Grix/LASDAC/Laser presentasjon.odp

## Laser DAC

  Av Gitle Mikkelsen, Thomas Heggland, Bård Gustav Hole Eide og Asbjørn Vik

## Oppgaven

- Designe en DAC for å styre en laser projektor
- Den skal følge ISP-DB25 protokollen.
- Kommunikasjon foregår over USB.

## Slide 3

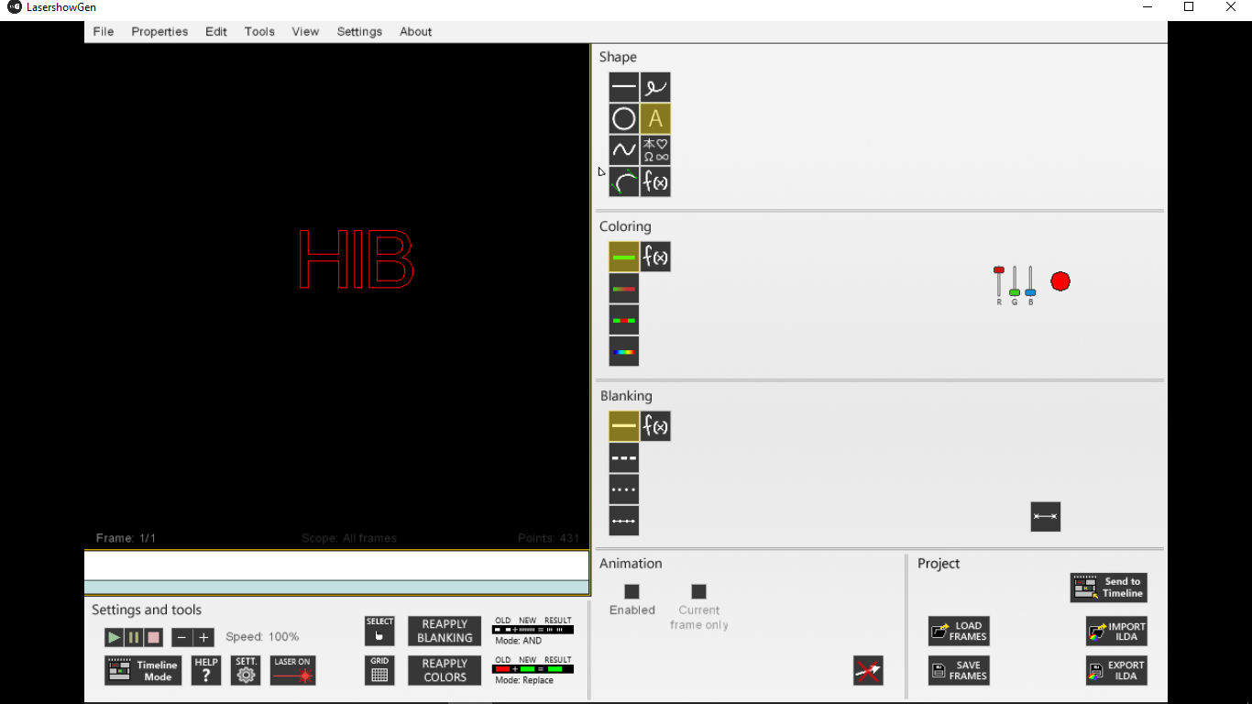
[picture p1: figure]

## Slide 4

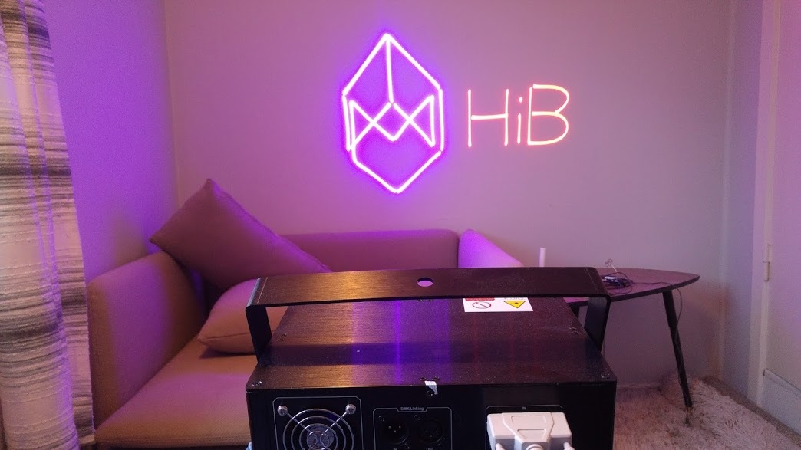
[picture p2: figure]

## Laserprojektorer

- Tegner ett bilde
- Hvert punkt har XY RGBI
- 30,000 punkter i sekundet
- Har begrensinger

## Analog del

- Designe forsterkere
- Velge dac løsning
- Strømforsyning
- Finne komponenter
- Designe kretskort

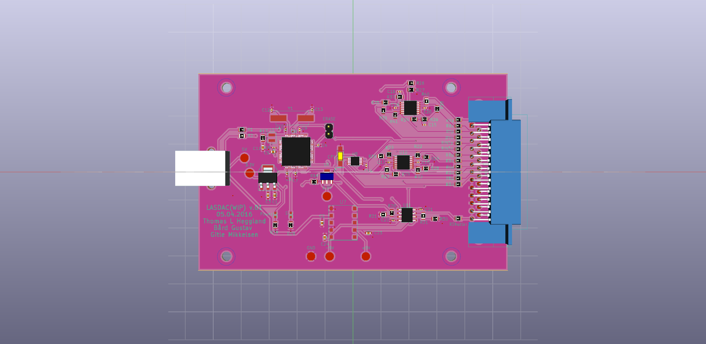
[picture p3: figure]

## Digital del

- Skrive firmware som kjører på mcu
- Skrive drivere

## Produksjon

- Får kortet produsert i Kina
- Feilsøking
- Levere

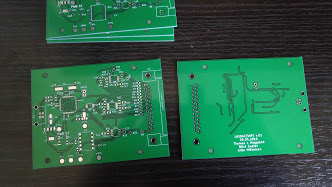
[picture p4: figure]
