Grix/LASDAC/documentation/lasdac_firmware_timechart_v0.1.pdf

### Lasdac firmware timechart v0.1

### Shutter output

### playing

### newFrameReady

### Frame Buffer 1 ( frame1[ ] )

### Frame Buffer 2 ( frame2[ ] )

DAC outputs | Blanked and centered | Blanked and centered

### frameAddress

newFrameAddress | frame2 | frame1 | frame2 | frame1

### framePos

### newFramePos

### USB isochronous data packet event

USB control packet event | | | | | | | STOP Shutter
H S | | ON | | Shutter OFF
Notes | | Several incoming USB isochronous packets contain data for the first laser frame | When transfer is finished, playing is enabled and the frame is gradually output to the DACs. Meanwhile, a second frame is being received over USB, filling the second frame buffer. | USB Control packets can issue various commands like setting shutter signal level. | The packets for the third frame (in blue) are received too late and the purple frame loops while the transfer finishes. | The packets for the fourth frame (in red) are received too early and are discarded because no buffers are available to store the data. | A STOP control packet stops and resets the output until a new frame is received.
frame1 | frame2 | frame1 | frame2

Time axis
