Grix/LASDAC/documentation/lasdac_firmware_flowchart_v0.4.pdf

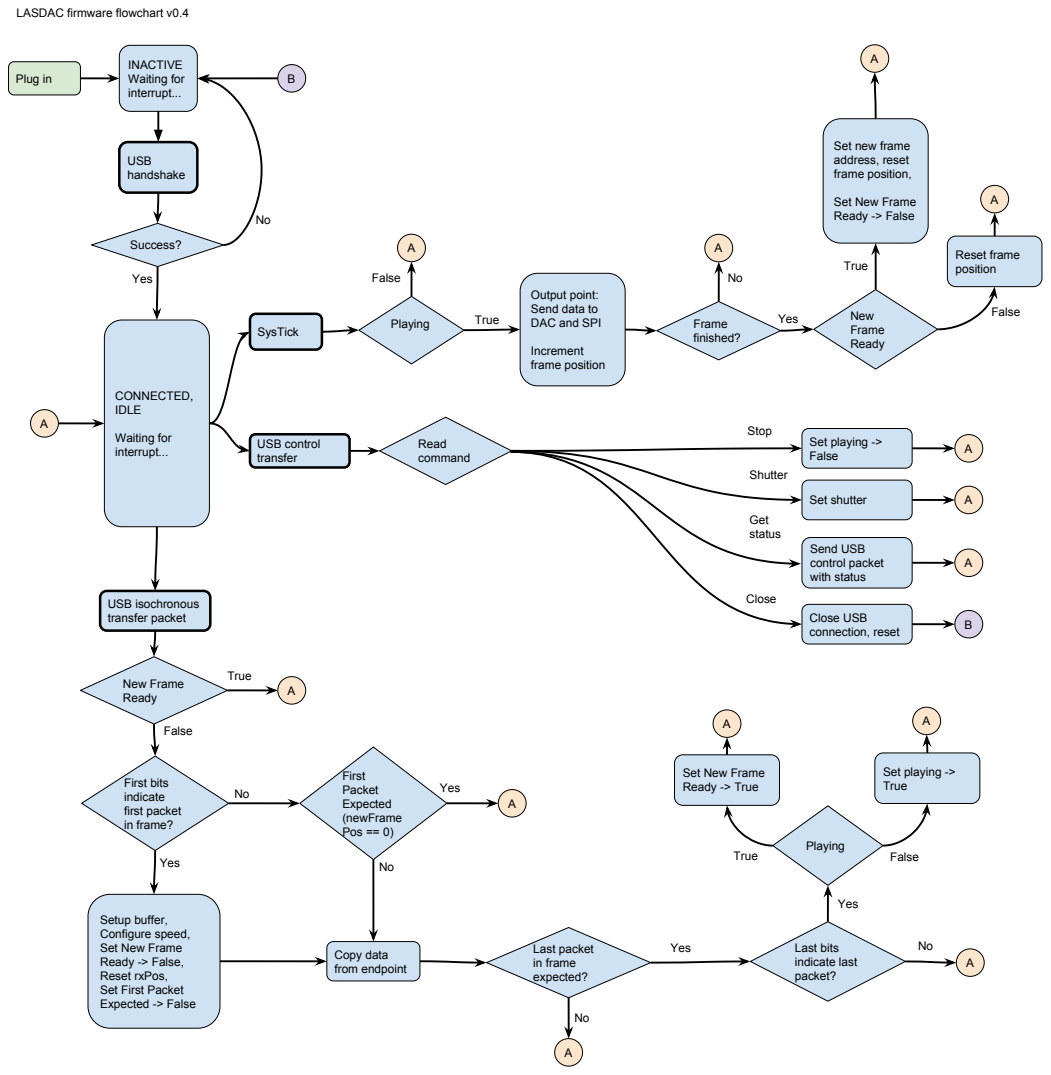
[picture p5: page 1]
INACTIVE Waiting for interrupt...; Success?; CONNECTED, IDLE; Waiting for interrupt...; USB handshake; Plug in; SysTick; Playing; Increment frame position; True; Frame; finished?; Yes; False; Reset frame position; USB control transfer; Read command; Set playing -> False; Stop; Set shutter; Shutter; Send USB control packet with status; Get status; Close USB connection, reset; Close; USB isochronous transfer packet; Copy data from endpoint; Last packet in frame expected?; New Frame Ready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

LASDAC firmware flowchart v0.4

Set new frame
address, reset
frame position,

Set New Frame
Ready -> False

Output point:
Send data to
DAC and SPI

Ready -> True

Setup buffer,
Configure speed,
Ready -> False,
Reset rxPos,
Set First Packet
Expected -> False
