Grix/LASDAC/ltspice/lasdac.asc

C1: cap; 0.05u
C2: cap; 0.05u
C3: cap; 390p
C4: cap; 390p
L1: ind; 500u; Rser=100
L2: ind; 500u; Rser=100
R1: res; 10k; tol=1
R2: res; 10k; tol=1
R3: res; 10k; tol=1
R4: res; 10k; tol=1
R5: res; 10k; tol=1
R6: res; 10k; tol=1
R7: res; 10k; tol=1
R8: res; 10k; tol=1
R9: res; 10k; tol=1
R10: res; 10k; tol=1
R11: res; 150; tol=1
R12: res; 1meg; tol=1
R13: res; 10k; tol=1
R14: res; 10k; tol=1
R15: res; 1.65k; tol=1
R16: res; 10k; tol=1
R17: res; 10k; tol=1
R18: res; 10k; tol=1
R19: res; 1.65k; tol=1
R20: res; 10k; tol=1
R21: res; 1.65k; tol=1
R22: res; 10k; tol=1
R23: res; 10k; tol=1
R24: res; 5.11k; tol=1
U1: tl084
U2: tl084
U3: tl084
U4: tl084
U5: tl084
U6: tl084
U7: tl084
U8: tl084
U9: tl084
U10: tl084
V1: voltage; 2.5; Rser=0.5
V2: voltage; PWL(0 0 0.997m 0 1m 2.5); Rser=7.5
V3: voltage; 9; Rser=10 Cpar=4.7u
V4: voltage; -9; Rser=10 Cpar=4.7u
V5: voltage; PWL(0 0.4167 0.997m 0.4167 1m 2.0833); Rser=3
V6: voltage; PWL(0 0 0.997m 0 1m 3.3); Rser=3
Named nets: 0, V2.5D, VN9D, V9D, VoRpos, VoGpos, VoBpos, VoIpos, ViB, ViG, ViR, ViI, VoBneg, VoGneg, VoRneg, VoIneg, V1.25D, VoXpos, ViY, ViX, VoXneg, VoYpos, VoYneg, VoS, ViS
.tran 0 2m 0m uic
Simple cable simulation
Voltage references
Color channels
X / Y channels
Shutter
