Grix/LASDAC/ltspice/powersupplies.asc

C1: cap; 321.4pF
C2: cap; 4.7uF
C3: cap; 100uF
C4: cap; 4.7uF
C5: cap; 257.9pF
C6: cap; 100uF
D1: schottky
D2: schottky
L1: ind; 216.5uH
L2: ind; 173.1uH
R1: res; 10k
R2: res; 62k
R3: res; 180
R4: res; 39.6m
R5: res; 1k
R6: res; 62k
R7: res; 10k
R8: res; 63m
R9: res; 1k
U1: MC34063
U2: MC34063
V1: voltage; 5V
V2: voltage; 5V
Named nets: 0
.tran 0.12 startup
