Grix/LASDAC/PCB/LASDAC.kicad_pcb

## KiCad design PCB/LASDAC.kicad_pcb (2016-04-17)

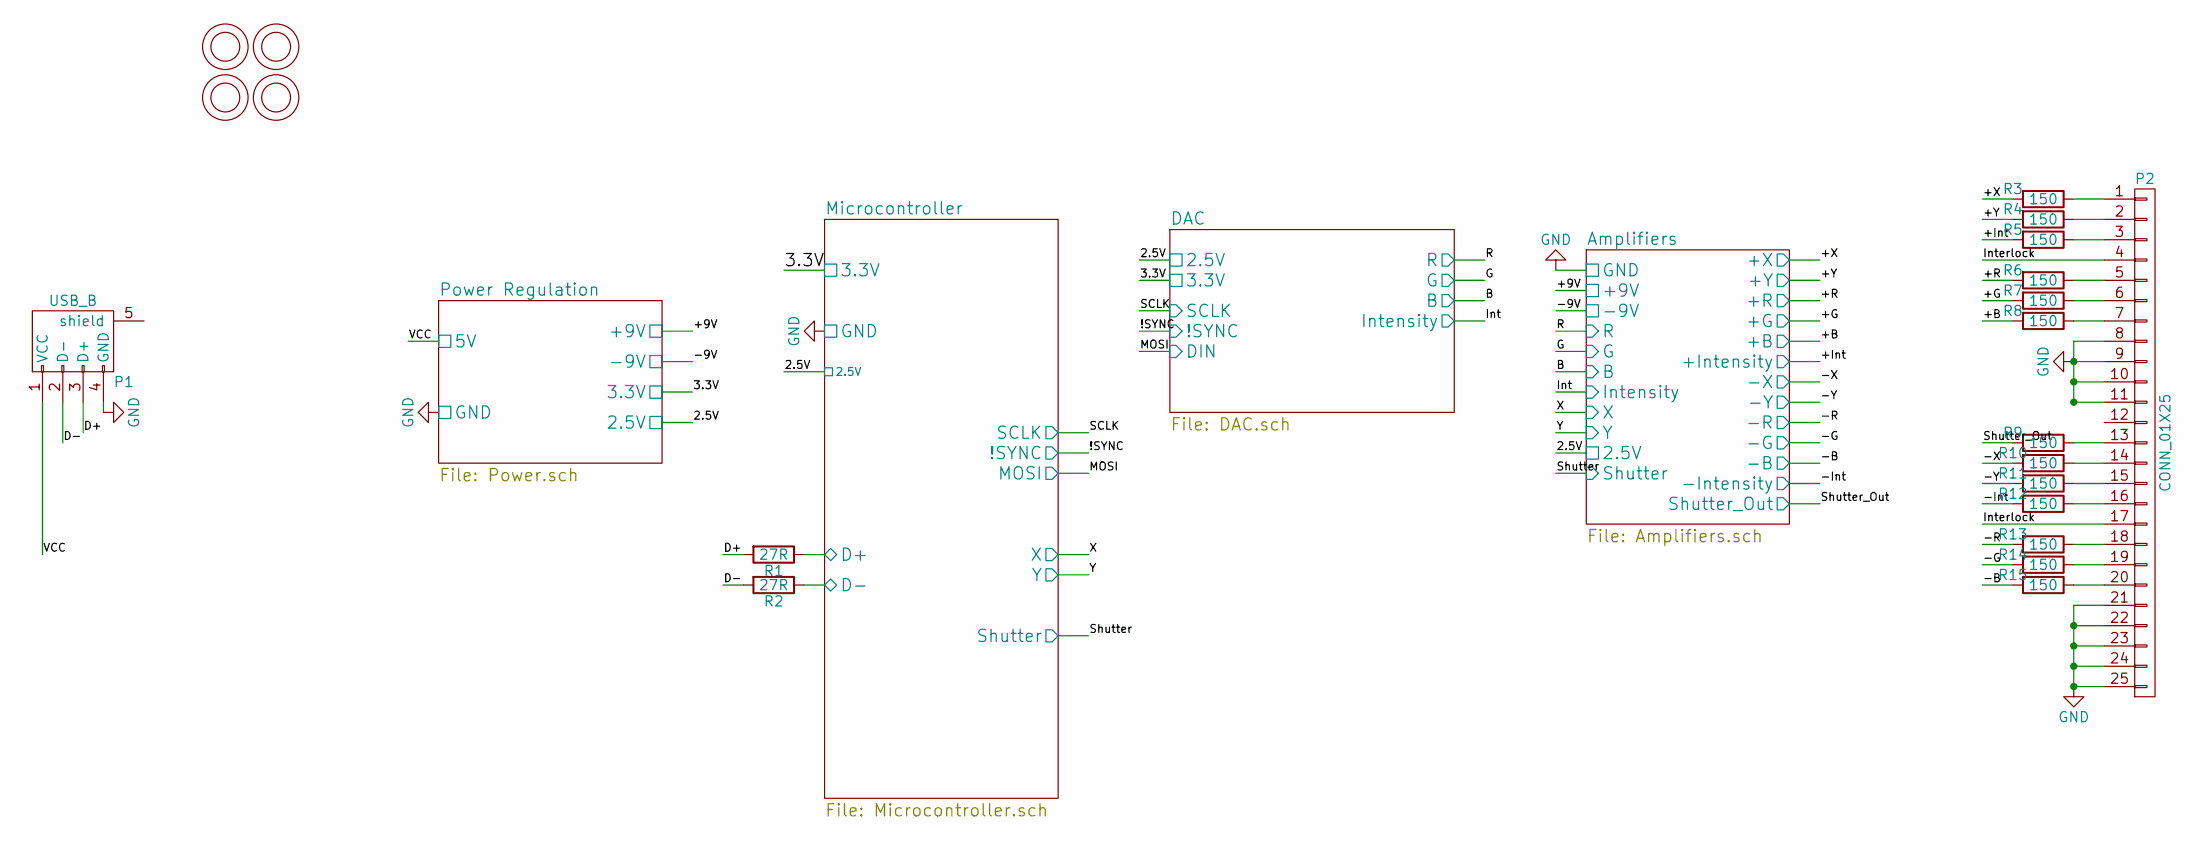
[picture p11: schematic LASDAC.sch, Main]

Parts:
H1, H2, H3, H4: Mounting_Hole; MountingHole_3.2mm_M3
P1: USB_B
P2: CONN_01X25; DB25FC
R1, R2: 27R; R_0805
R3, R4, R5, R6, R7, R8, R9, R10, R11, R12, R13, R14, R15: 150; R_0805

Connections:
/Amplifiers/+B: R8.2; also elsewhere on the board
/Amplifiers/+G: R7.2; also elsewhere on the board
/Amplifiers/+Intensity: R5.2; also elsewhere on the board
/Amplifiers/+R: R6.2; also elsewhere on the board
/Amplifiers/+X: R3.2; also elsewhere on the board
/Amplifiers/+Y: R4.2; also elsewhere on the board
/Amplifiers/-B: R15.2; also elsewhere on the board
/Amplifiers/-G: R14.2; also elsewhere on the board
/Amplifiers/-Intensity: R12.2; also elsewhere on the board
/Amplifiers/-R: R13.2; also elsewhere on the board
/Amplifiers/-X: R10.2; also elsewhere on the board
/Amplifiers/-Y: R11.2; also elsewhere on the board
/Amplifiers/Shutter_Out: R9.2; also elsewhere on the board
/D+: P1.3 (D+), R1.2
/D-: P1.2 (D-), R2.2
/Interlock: P2.4, P2.17
/Microcontroller/D+: R1.1; also elsewhere on the board
/Microcontroller/D-: R2.1; also elsewhere on the board
/Power Regulation/5V: P1.1 (VCC); also elsewhere on the board
GND: P1.4 (GND), P2.8, P2.9, P2.10, P2.11, P2.21, P2.22, P2.23, P2.24, P2.25; also elsewhere on the board
unnamed: P2.1, R3.1
unnamed: P2.2, R4.1
unnamed: P2.3, R5.1
unnamed: P2.5, R6.1
unnamed: P2.6, R7.1
unnamed: P2.7, R8.1
unnamed: P2.13, R9.1
unnamed: P2.14, R10.1
unnamed: P2.15, R11.1
unnamed: P2.16, R12.1
unnamed: P2.18, R13.1
unnamed: P2.19, R14.1
unnamed: P2.20, R15.1

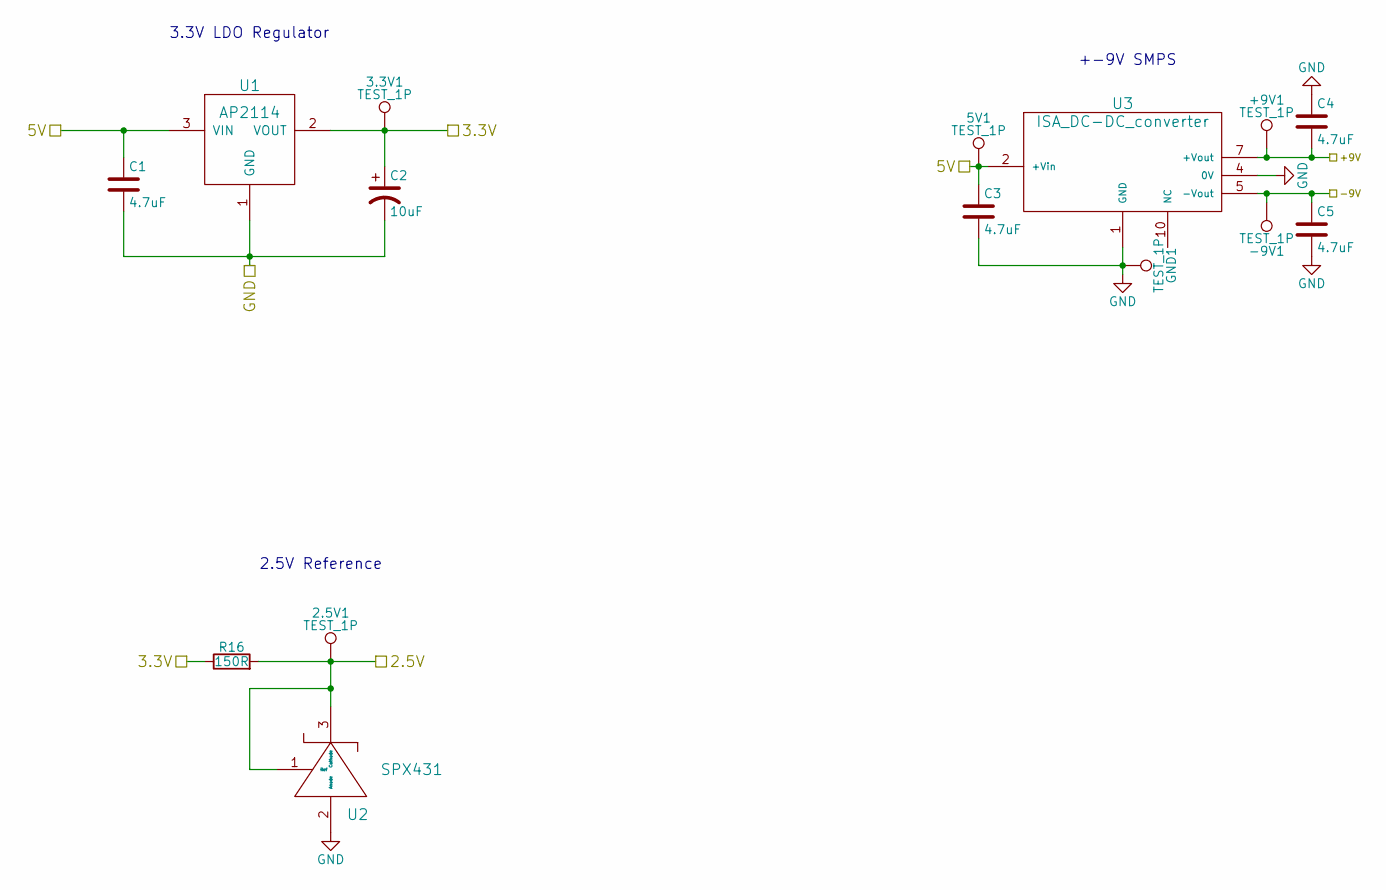
[picture p12: schematic Power.sch, Power Supplies]

Parts:
2.5V1, 3.3V1, 5V1: TEST_1P; Measurement_Point_Round-SMD-Pad_Big
+9V1: TEST_1P; Measurement_Point_Round-SMD-Pad_Big
-9V1: TEST_1P; Measurement_Point_Round-SMD-Pad_Big
C1, C4, C5: 4.7uF; C_0603
C2: 10uF
C3: 4.7uF; c_elec_4x5.8
GND1: TEST_1P; Measurement_Point_Round-SMD-Pad_Big
R16: 150R; R_0805
U1: AP2114; SOT-223
U2: SPX431; SOT89-3_Housing
U3: ISA_DC-DC_converter; SOIC-10

Connections:
/Amplifiers/2.5V: 2.5V1.1, R16.2, U2.1 (Ref), U2.3 (Cathode); also elsewhere on the board
/Amplifiers/+9V: +9V1.1, C4.2, U3.7 (+Vout); also elsewhere on the board
/Amplifiers/-9V: -9V1.1, C5.1, U3.5 (-Vout); also elsewhere on the board
/DAC/3.3V: 3.3V1.1, C2.1, R16.1, U1.2 (VOUT); also elsewhere on the board
/Power Regulation/5V: 5V1.1, C1.1, C3.1, U1.3 (VIN), U3.2 (+Vin); also elsewhere on the board
GND: C1.2, C2.2, C3.2, C4.1, C5.2, GND1.1, U1.1 (GND), U2.2 (Anode), U3.1 (GND), U3.4 (0V); also elsewhere on the board

Notes on the sheet:
3.3V LDO Regulator
+-9V SMPS
2.5V Reference

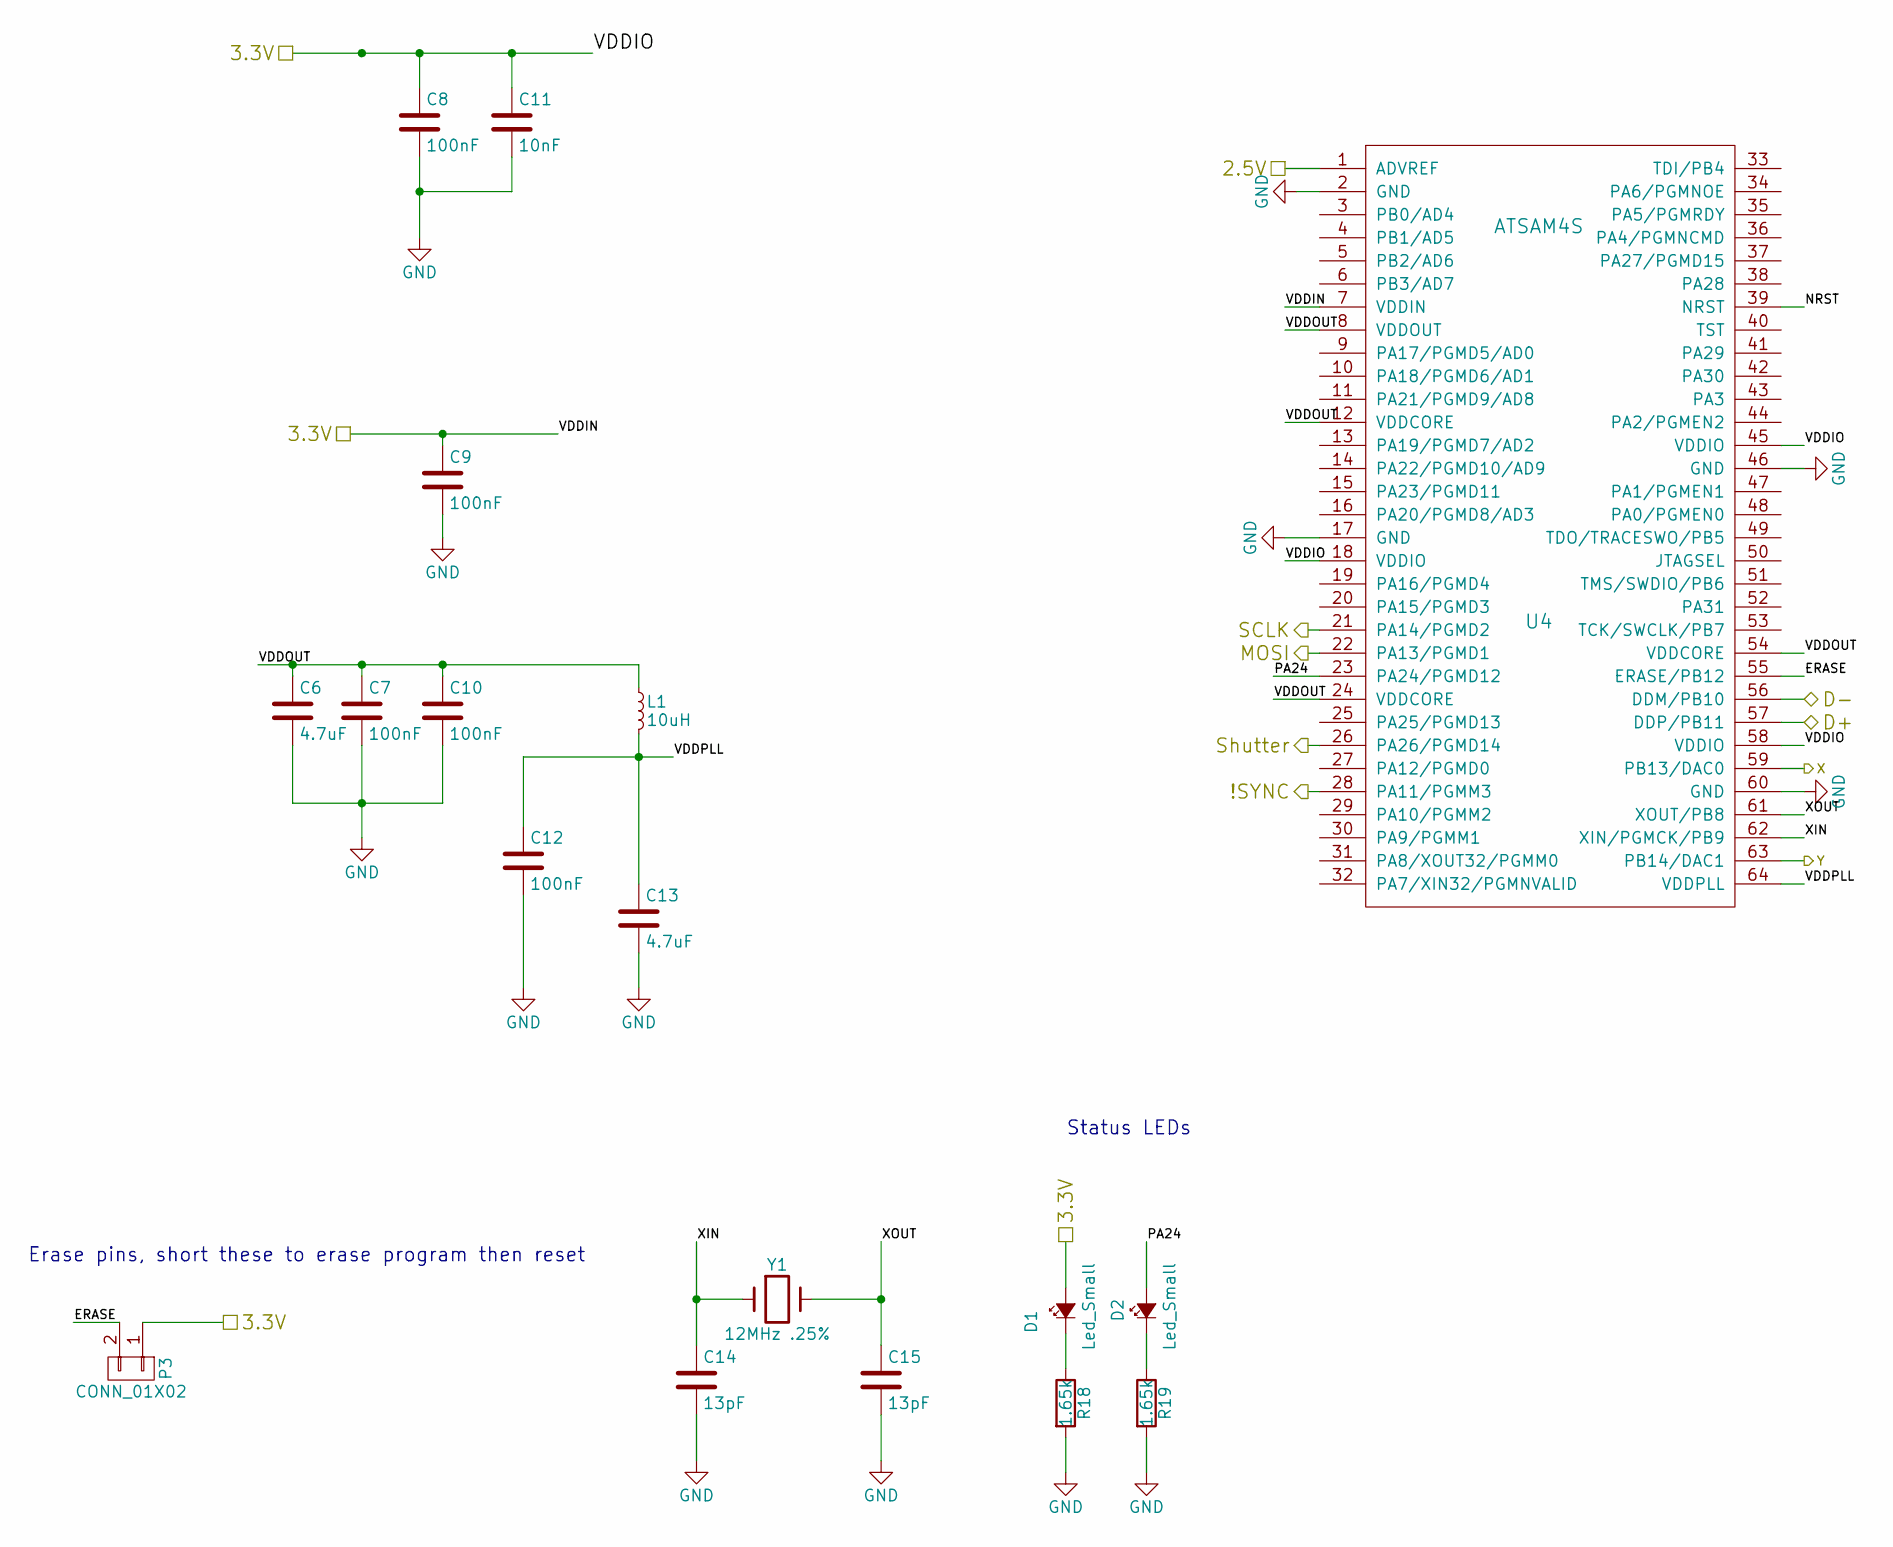
[picture p13: schematic Microcontroller.sch, Microcontroller]

Parts:
C6, C13: 4.7uF; C_0603
C7, C8, C9, C10, C12: 100nF; C_0402
C11: 10nF; C_0402
C14, C15: 13pF; C_0402
D1, D2: Led_Small; LED_0603
L1: 10uH; Inductor_SM_1008i2520m
P3: CONN_01X02
R18, R19: 1.65k; R_0805
U4: ATSAM4S; LQFP-64_10x10mm_Pitch0.5mm
Y1: 12MHz .25%; Crystal_HC49-SD_SMD

Connections:
/Amplifiers/2.5V: U4.1 (ADVREF); also elsewhere on the board
/Amplifiers/Shutter: U4.26 (PA26/PGMD14); also elsewhere on the board
/Amplifiers/X: U4.59 (PB13/DAC0); also elsewhere on the board
/Amplifiers/Y: U4.63 (PB14/DAC1); also elsewhere on the board
/DAC/3.3V: C8.1, C9.1, C11.1, D1.2 (A), P3.1, U4.7 (VDDIN), U4.18 (VDDIO), U4.45 (VDDIO), U4.58 (VDDIO); also elsewhere on the board
/DAC/!SYNC: U4.28 (PA11/PGMM3); also elsewhere on the board
/DAC/Din: U4.22 (PA13/PGMD1); also elsewhere on the board
/DAC/SCLK: U4.21 (PA14/PGMD2); also elsewhere on the board
/Microcontroller/D+: U4.57 (DDP/PB11); also elsewhere on the board
/Microcontroller/D-: U4.56 (DDM/PB10); also elsewhere on the board
/Microcontroller/ERASE: P3.2, U4.55 (ERASE/PB12); also elsewhere on the board
/Microcontroller/NRST: U4.39 (NRST)
/Microcontroller/PA24: D2.2 (A), U4.23 (PA24/PGMD12)
/Microcontroller/VDDOUT: C6.1, C7.1, C10.1, L1.1, U4.8 (VDDOUT), U4.12 (VDDCORE), U4.24 (VDDCORE), U4.54 (VDDCORE)
/Microcontroller/VDDPLL: C12.1, C13.1, L1.2, U4.64 (VDDPLL)
/Microcontroller/XIN: C14.1, U4.62 (XIN/PGMCK/PB9), Y1.1
/Microcontroller/XOUT: C15.1, U4.61 (XOUT/PB8), Y1.2
GND: C6.2, C7.2, C8.2, C9.2, C10.2, C11.2, C12.2, C13.2, C14.2, C15.2, R18.2, R19.2, U4.2 (GND), U4.17 (GND), U4.46 (GND), U4.60 (GND); also elsewhere on the board
unnamed: D1.1 (K), R18.1
unnamed: D2.1 (K), R19.1

Notes on the sheet:
Erase pins, short these to erase program then reset
Status LEDs

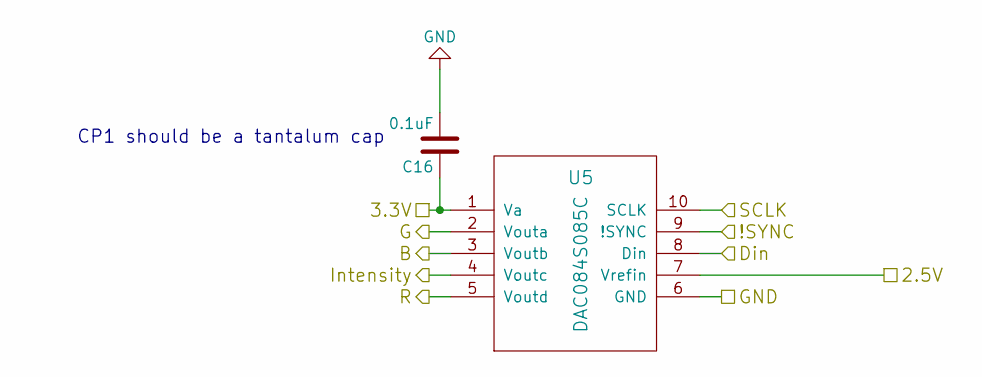
[picture p14: schematic DAC.sch, Digital to Analog Converter]

Parts:
C16: 0.1uF; C_0402
U5: DAC084S085C; MSOP-10_3x3mm_Pitch0.5mm

Connections:
/Amplifiers/2.5V: U5.7 (Vrefin); also elsewhere on the board
/Amplifiers/+B: U5.3 (Voutb); also elsewhere on the board
/Amplifiers/+G: U5.2 (Vouta); also elsewhere on the board
/Amplifiers/+Intensity: U5.4 (Voutc); also elsewhere on the board
/Amplifiers/+R: U5.5 (Voutd); also elsewhere on the board
/DAC/3.3V: C16.1, U5.1 (Va); also elsewhere on the board
/DAC/!SYNC: U5.9 (!SYNC); also elsewhere on the board
/DAC/Din: U5.8 (Din); also elsewhere on the board
/DAC/SCLK: U5.10 (SCLK); also elsewhere on the board
GND: C16.2, U5.6 (GND); also elsewhere on the board

Notes on the sheet:
CP1 should be a tantalum cap

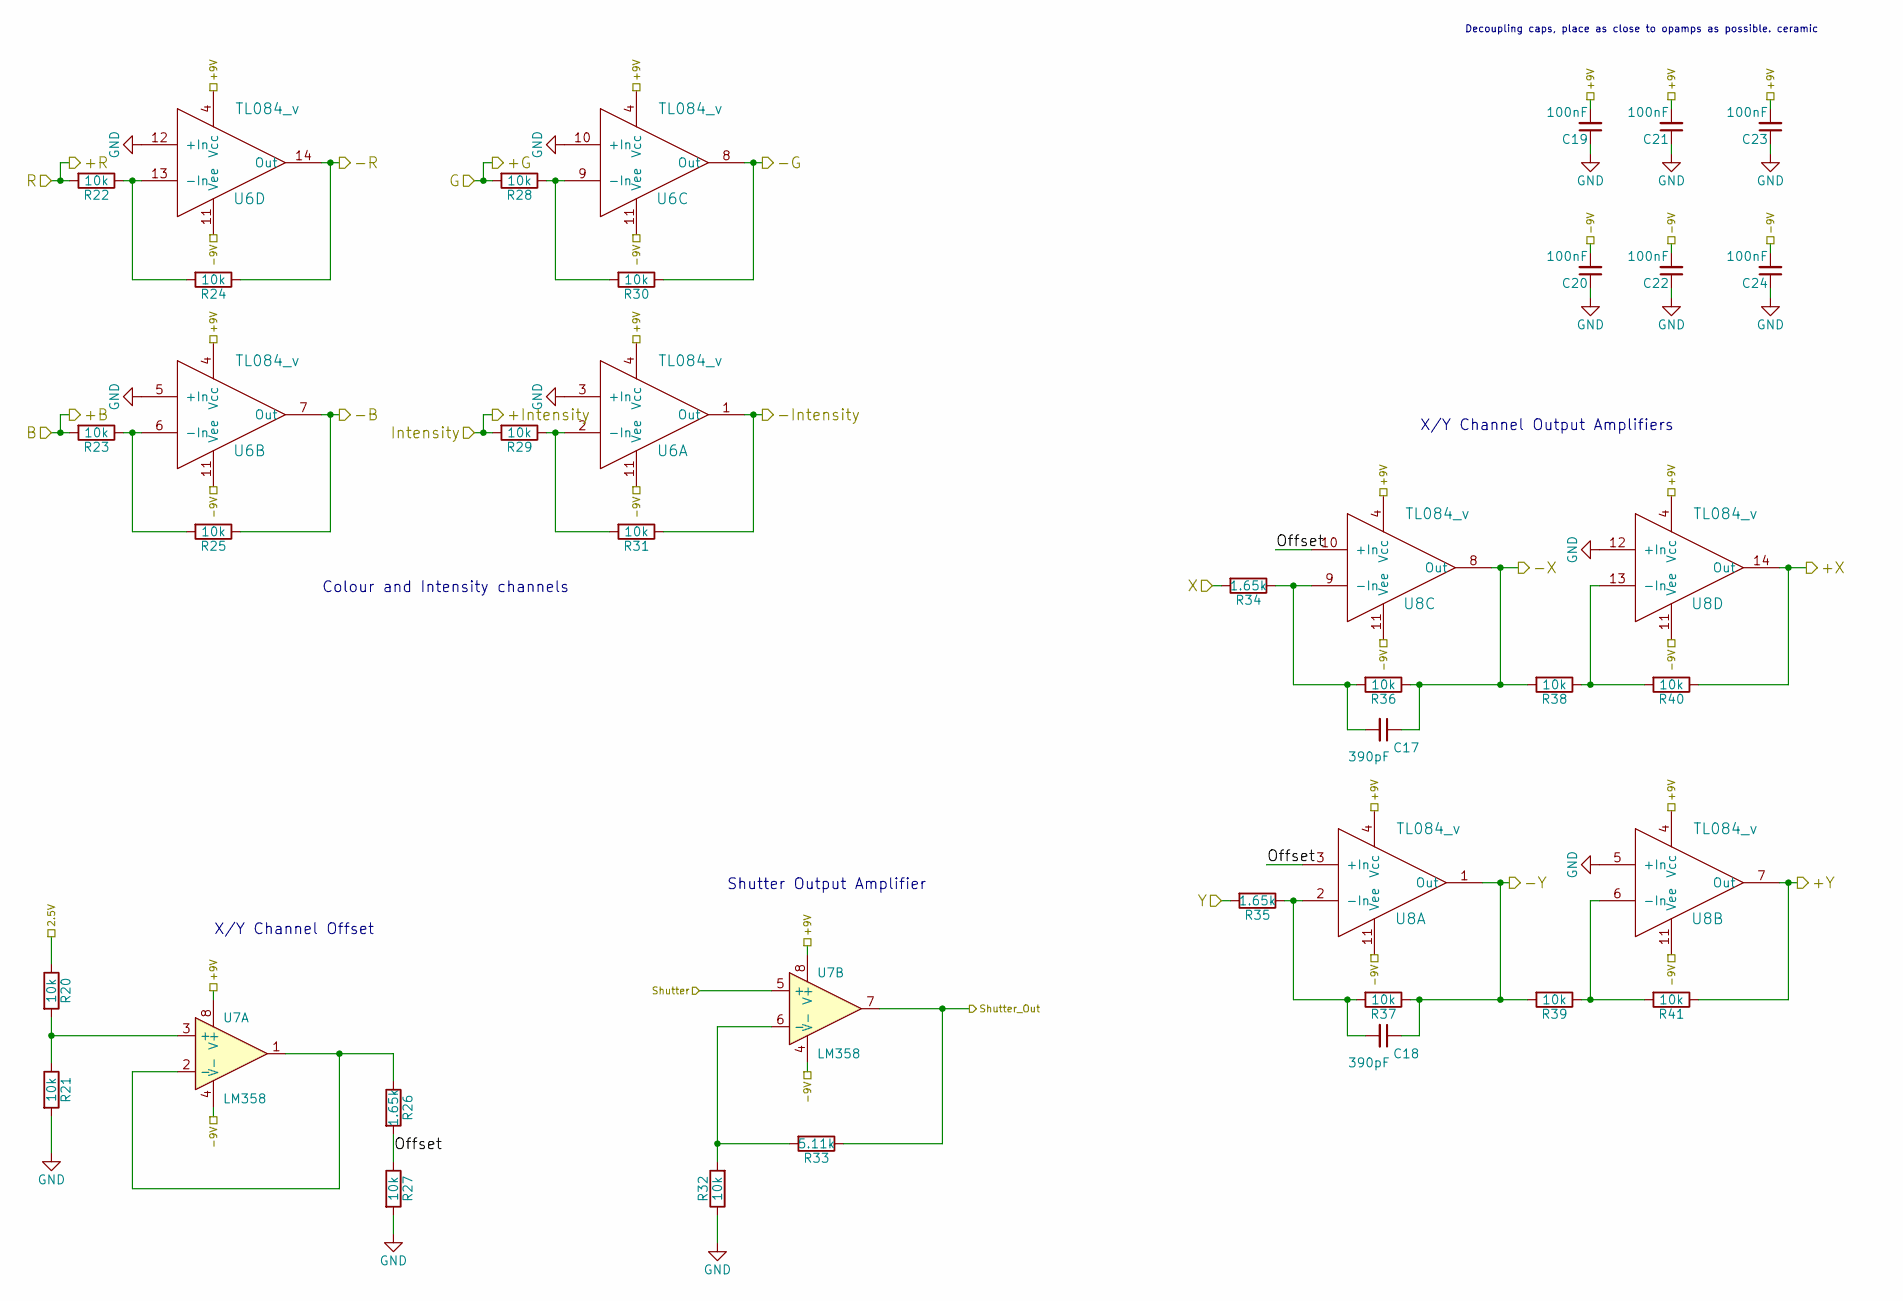
[picture p15: schematic Amplifiers.sch]

Parts:
C17, C18: 390pF; C_0402
C19, C20, C21, C22, C23, C24: 100nF; C_0402
R20, R21, R22, R23, R24, R25, R27, R28, R29, R30, R31, R32, R36, R37, R38, R39, R40, R41: 10k; R_0805
R26, R34, R35: 1.65k; R_0805
R33: 5.11k; R_0805
U6, U8: TL084_v; TSSOP-14_4.4x5mm_Pitch0.65mm
U7: LM358; SOIC-8_3.9x4.9mm_Pitch1.27mm

Connections:
/Amplifiers/2.5V: R20.1; also elsewhere on the board
/Amplifiers/+9V: C19.2, C21.2, C23.2, U6.4 (Vcc), U7.8 (V+), U8.4 (Vcc); also elsewhere on the board
/Amplifiers/+B: R23.2; also elsewhere on the board
/Amplifiers/+G: R28.2; also elsewhere on the board
/Amplifiers/+Intensity: R29.2; also elsewhere on the board
/Amplifiers/+R: R22.2; also elsewhere on the board
/Amplifiers/+X: R40.1, U8.14 (Out); also elsewhere on the board
/Amplifiers/+Y: R41.1, U8.7 (Out); also elsewhere on the board
/Amplifiers/-9V: C20.2, C22.2, C24.2, U6.11 (Vee), U7.4 (V-), U8.11 (Vee); also elsewhere on the board
/Amplifiers/-B: R25.1, U6.7 (Out); also elsewhere on the board
/Amplifiers/-G: R30.1, U6.8 (Out); also elsewhere on the board
/Amplifiers/-Intensity: R31.1, U6.1 (Out); also elsewhere on the board
/Amplifiers/-R: R24.1, U6.14 (Out); also elsewhere on the board
/Amplifiers/-X: C17.1, R36.1, R38.2, U8.8 (Out); also elsewhere on the board
/Amplifiers/-Y: C18.1, R37.1, R39.2, U8.1 (Out); also elsewhere on the board
/Amplifiers/Offset: R26.2, R27.1, U8.3 (+In), U8.10 (+In)
/Amplifiers/Shutter: U7.5 (+); also elsewhere on the board
/Amplifiers/Shutter_Out: R33.1, U7.7; also elsewhere on the board
/Amplifiers/X: R34.2; also elsewhere on the board
/Amplifiers/Y: R35.2; also elsewhere on the board
GND: C19.1, C20.1, C21.1, C22.1, C23.1, C24.1, R21.2, R27.2, R32.1, U6.3 (+In), U6.5 (+In), U6.10 (+In), U6.12 (+In), U8.5 (+In), U8.12 (+In); also elsewhere on the board
unnamed: C17.2, R34.1, R36.2, U8.9 (-In)
unnamed: C18.2, R35.1, R37.2, U8.2 (-In)
unnamed: R20.2, R21.1, U7.3 (+)
unnamed: R22.1, R24.2, U6.13 (-In)
unnamed: R23.1, R25.2, U6.6 (-In)
unnamed: R26.1, U7.1, U7.2 (-)
unnamed: R28.1, R30.2, U6.9 (-In)
unnamed: R29.1, R31.2, U6.2 (-In)
unnamed: R32.2, R33.2, U7.6 (-)
unnamed: R38.1, R40.2, U8.13 (-In)
unnamed: R39.1, R41.2, U8.6 (-In)

Notes on the sheet:
Decoupling caps, place as close to opamps as possible. ceramic
Colour and Intensity channels
Shutter Output Amplifier
X/Y Channel Offset
X/Y Channel Output Amplifiers

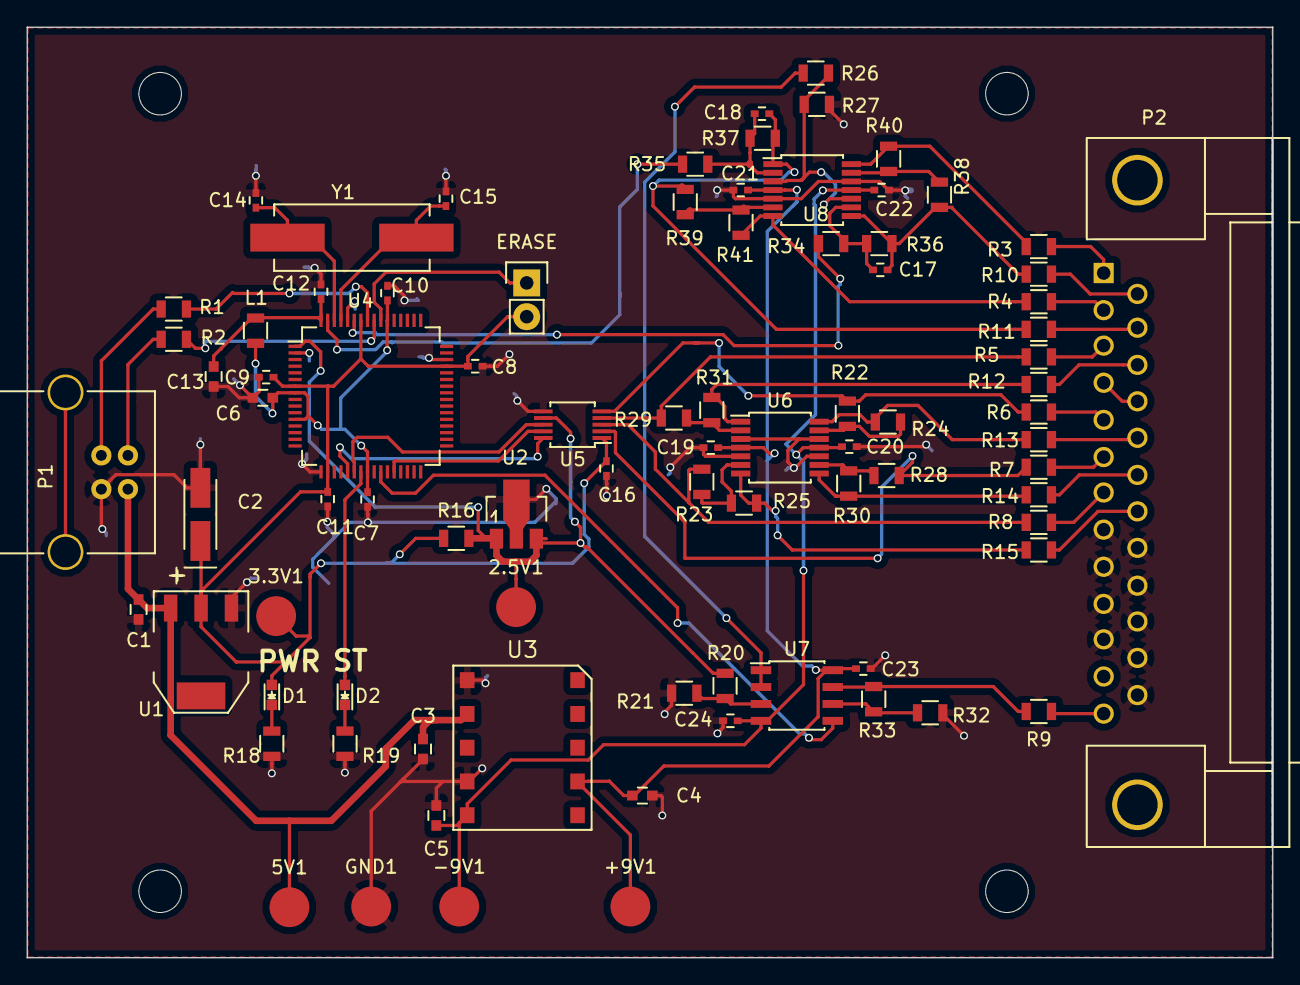
[picture p16: board LASDAC.kicad_pcb from above]

Board: 2 copper layers, 93.7 x 70.0 mm, 89 parts (0 on the bottom side), 63 nets.

Other parts of the board:
ERASE: SW_PUSH; Pin_Header_Straight_1x02

Their connections:
/DAC/3.3V: ERASE.2; also elsewhere on the board
/Microcontroller/ERASE: ERASE.1; also elsewhere on the board
