Grix/LASDAC/sam4s2b/lasdac_mainfirmware/lasdac_mainfirmware/src/main.c

/*
Lasdac main prosjekt (for SAM4S2B board)

Required Atmel Software Framework modules:
	DACC - Digital-to-Analog Converter
	Generic Board Support (ATSAM4S2B)
	GPIO
	IOPORT
	PIO
	SPI - Serial Peripheral Interface
	USB Device Vendor Class
	WDT - Watchdog Timer
*/

#include "main.h"
#include <malloc.h>

//ENTRY
int main (void)
{
	//allocate memory to buffers
	frameAddress = malloc(MAXFRAMESIZE * 8);
	newFrameAddress = malloc(MAXFRAMESIZE * 8);
	usbBulkBufferAddress = malloc(MAXFRAMESIZE * 8);
	usbInterruptBufferAddress = malloc(8);
	
	//start modules
	sysclk_init();
	pmc_disable_all_periph_clk();
	pmc_disable_pllbck();
	dac_init();
	spi_init();
	iopins_init();
	irq_initialize_vectors();
	cpu_irq_enable();
	sleepmgr_init();
	udc_start();
	wdt_disable(WDT);
	
	//set systick higher priority to avoid pauses in playback when processing USB transfers
	NVIC_SetPriority(SysTick_IRQn, 0); 
	NVIC_SetPriority(UDP_IRQn, 1);
	
	//default output
	shutter_set(LOW);
	statusled_set(LOW);
	blank_and_center();
	
	sleepmgr_lock_mode(SLEEPMGR_WAIT_FAST);
	
	//waiting for interrupts..
	while (true)
		sleepmgr_enter_sleep();
}

void SysTick_Handler(void) //systick timer ISR, called for each point
{
	if (playing)
	{
		if (framePos >= frameSize) //if frame reached the end
		{
			if (newFrameReady)
			{
				//load new frame, switch buffers
				uint8_t* previousFrameAddress = frameAddress;
				frameAddress = newFrameAddress;
				newFrameAddress = previousFrameAddress;
				newFrameReady = false;
				framePos = 0;
				frameSize = newFrameSize;
				notRepeat = newNotRepeat;
				point_output();
				framePos += 8;
				speed_set(outputSpeed);
			}
			else
			{
				if (!notRepeat)
				{
					//loop frame
					framePos = 0;
					point_output();
					framePos += 8;
				}
				else
				{
					framePos = 0;
					playing = false;
					blank_and_center();
				}
				
			}
		}
		else
		{
			//output current point
			point_output();
			framePos += 8;
		}
	}
}

void usb_bulk_out_callback(udd_ep_status_t status, iram_size_t length, udd_ep_id_t ep)
{
	UNUSED(ep);
	
	//multi-byte values are little endian
	//0-n:	frame data, point is 16bit X, 16bit Y, 8bit R, 8bit G, 8bit B, 8bit I
	//n:	output rate 16bit
	//n+2:	frame size in points 16bit
	//n+4:	flags
	
	if ( (status == UDD_EP_TRANSFER_OK) && (length <= MAXFRAMESIZE * 8 + 5) ) //if not invalid
	{
		uint16_t numOfPointBytes = length - 5; //from length of received data
		uint16_t numOfPointBytes2 = ((usbBulkBufferAddress[numOfPointBytes + 3] << 8) + usbBulkBufferAddress[numOfPointBytes + 2]) * 8; //from control bytes
		
		if (numOfPointBytes == numOfPointBytes2) //sanity check, skip frame if conflicting frame size information
		{
			cpu_irq_enter_critical();
				uint8_t flags = usbBulkBufferAddress[numOfPointBytes + 4];
				newNotRepeat = (flags & (1 << 1));
				outputSpeed = (usbBulkBufferAddress[numOfPointBytes + 1] << 8) + usbBulkBufferAddress[numOfPointBytes + 0];			
			
				if ( (!playing) || (flags & (1 << 0)) ) //if frame is to start playing immediately
				{
					uint8_t* previousFrameAddress = frameAddress;
					frameAddress = usbBulkBufferAddress;
					usbBulkBufferAddress = previousFrameAddress;
					framePos = 0;
					frameSize = numOfPointBytes;
					newFrameReady = false;
					playing = true;
					notRepeat = newNotRepeat;
					speed_set(outputSpeed);
				} 
				else
				{
					uint8_t* previousNewFrameAddress = newFrameAddress;
					newFrameAddress = usbBulkBufferAddress;
					usbBulkBufferAddress = previousNewFrameAddress;	
					newFrameSize = numOfPointBytes;
					newFrameReady = true;
				}
			cpu_irq_leave_critical();
		}
	}
	
	udi_vendor_bulk_out_run(usbBulkBufferAddress, MAXFRAMESIZE * 8 + 5, usb_bulk_out_callback);
}

void usb_interrupt_out_callback(udd_ep_status_t status, iram_size_t length, udd_ep_id_t ep)
{
	//	Byte 0: Command
	//	Byte 1-2: Data (little endian)
	
	UNUSED(ep);
	if ( (status == UDD_EP_TRANSFER_OK) && (length == 3) )
	{	
		if (usbInterruptBufferAddress[0] == 0x01)		//STOP
		{
			playing = false;
			framePos = 0;
			blank_and_center();
		}
		else if (usbInterruptBufferAddress[0] == 0x02)	//SHUTTER
		{
			shutter_set( (usbInterruptBufferAddress[1] && true) );
		}
		else if (usbInterruptBufferAddress[0] == 0x03)	//STATUS_REQUEST
		{
			//TODO
		}
	}
	
	udi_vendor_interrupt_out_run(usbInterruptBufferAddress, 3, usb_interrupt_out_callback);
}



inline void point_output(void) //sends point data to the DACs, data is point number "framePos" in buffer "frameAddress".
{
	uint8_t* currentPoint = frameAddress + framePos;
	
	spi_write(SPI, (currentPoint[5] << 4) + (0b0001 << 12), 0, 0); //G
	spi_write(SPI, (currentPoint[6] << 4) + (0b0101 << 12), 0, 0); //B
	spi_write(SPI, (currentPoint[7] << 4) + (0b1001 << 12), 0, 0); //I
	spi_write(SPI, (currentPoint[4] << 4) + (0b1101 << 12), 0, 0); //R
	
	if ((dacc_get_interrupt_status(DACC) & DACC_ISR_TXRDY) == DACC_ISR_TXRDY) //if DAC ready
	{
		dacc_set_channel_selection(DACC, 0);
		dacc_write_conversion_data(DACC, (currentPoint[1] << 8) + currentPoint[0] ); //X
		dacc_set_channel_selection(DACC, 1);
		dacc_write_conversion_data(DACC, (currentPoint[3] << 8) + currentPoint[2] ); //Y
	}
	
	statusled_set( (currentPoint[4] || currentPoint[5] || currentPoint[6] || currentPoint[7]) ); //turn on status led if not blanked
}

inline void blank_and_center(void) //outputs a blanked and centered point
{
	spi_write(SPI, (0b0010 << 12), 0, 0); //blank all colors
	
	if ((dacc_get_interrupt_status(DACC) & DACC_ISR_TXRDY) == DACC_ISR_TXRDY) //if DAC ready
	{
		dacc_set_channel_selection(DACC, 0);
		dacc_write_conversion_data(DACC, 0 ); //X
		dacc_set_channel_selection(DACC, 1);
		dacc_write_conversion_data(DACC, 0 ); //Y
	}
	
	statusled_set(LOW);
}

inline void speed_set(uint32_t rate) //set the output speed in points per second
{
	if (rate > MAXSPEED)
	rate = MAXSPEED;
	else if (rate < MINSPEED)
	rate = MINSPEED;
	outputSpeed = rate;
	SysTick_Config( (sysclk_get_cpu_hz() / rate) + 1);
}

int callback_vendor_enable(void) //usb connection opened, preparing for activity
{
	sleepmgr_unlock_mode(SLEEPMGR_WAIT_FAST);
	sleepmgr_lock_mode(SLEEPMGR_ACTIVE);
	
	udi_vendor_bulk_out_run(usbBulkBufferAddress, MAXFRAMESIZE * 8 + 5, usb_bulk_out_callback);
	udi_vendor_interrupt_out_run(usbInterruptBufferAddress, 3, usb_interrupt_out_callback);
	
	return 1;
}

void callback_vendor_disable(void) //usb connection closed, sleeping to save power
{
	playing = false;
	framePos = 0;
	blank_and_center();
	statusled_set(LOW);
	
	sleepmgr_unlock_mode(SLEEPMGR_ACTIVE);
	sleepmgr_lock_mode(SLEEPMGR_WAIT_FAST);
}

inline void shutter_set(bool level)
{
	//ioport_set_pin_level(PIN_SHUTTER, level);
}

inline void statusled_set(bool level)
{
	ioport_set_pin_level(PIN_STATUSLED, level);
}

//INIT FUNCTIONS:

void iopins_init(void) //setup io pins config
{
	ioport_set_pin_dir(PIN_SHUTTER, IOPORT_DIR_OUTPUT);
	ioport_set_pin_dir(PIN_STATUSLED, IOPORT_DIR_OUTPUT);
}

void spi_init(void) //setup SPI for DAC084S085
{
	gpio_configure_pin(SPI_MISO_GPIO, SPI_MISO_FLAGS);
	gpio_configure_pin(SPI_MOSI_GPIO, SPI_MOSI_FLAGS);
	gpio_configure_pin(SPI_SPCK_GPIO, SPI_SPCK_FLAGS);
	gpio_configure_pin(SPI_NPCS0_GPIO, SPI_NPCS0_FLAGS);
	spi_enable_clock(SPI);
	spi_disable(SPI);
	spi_reset(SPI);
	spi_set_master_mode(SPI);
	spi_set_fixed_peripheral_select(SPI);
	spi_disable_mode_fault_detect(SPI);
	spi_configure_cs_behavior(SPI, 0, SPI_CS_RISE_FORCED);
	spi_set_delay_between_chip_select(SPI, 6);
	spi_set_peripheral_chip_select_value(SPI, spi_get_pcs(0));
	spi_set_clock_polarity(SPI, 0, 0);
	spi_set_clock_phase(SPI, 0, 0);
	spi_set_bits_per_transfer(SPI, 0, SPI_CSR_BITS_16_BIT);
	spi_set_baudrate_div(SPI, 0, 7 ); //96MHz / 7 = 13.714..MHz
	spi_set_transfer_delay(SPI, 0, 0, 0);
	spi_enable(SPI);
}

void dac_init(void) //setup sam internal DAC controller
{
	sysclk_enable_peripheral_clock(ID_DACC);
	dacc_reset(DACC);
	dacc_enable_channel(DACC, 0);
	dacc_enable_channel(DACC, 1);
	dacc_set_transfer_mode(DACC, 0);
}
