Grix/LASDAC/usb_testprogram/usb_firmware_test/temp_DEVICE_EXAMPLE1/temp_DEVICE_EXAMPLE1/src/main.c

/**
 * \file
 *
 * \brief Main functions for USB Device vendor example
 *
 * Copyright (c) 2011-2015 Atmel Corporation. All rights reserved.
 *
 * \asf_license_start
 *
 * \page License
 *
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
 * 3. The name of Atmel may not be used to endorse or promote products derived
 *    from this software without specific prior written permission.
 *
 * 4. This software may only be redistributed and used in connection with an
 *    Atmel microcontroller product.
 *
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
 * \asf_license_stop
 *
 */
/*
 * Support and FAQ: visit <a href="http://www.atmel.com/design-support/">Atmel Support</a>
 */

#include <asf.h>
#include "conf_usb.h"
#include "ui.h"

static volatile bool main_b_vendor_enable = false;

/**
 * \name Buffer for loopback
 */
//@{
//! Size of buffer used for the loopback
#define  MAIN_LOOPBACK_SIZE    32768
COMPILER_WORD_ALIGNED
		static uint8_t main_buf_loopback[MAIN_LOOPBACK_SIZE];
static uint8_t main_buf_iso_sel;
//@}

// check configuration
#if UDI_VENDOR_EPS_SIZE_ISO_FS>(MAIN_LOOPBACK_SIZE/2)
# error UDI_VENDOR_EPS_SIZE_ISO_FS must be <= MAIN_LOOPBACK_SIZE/2 in cond_usb.h
#endif
#ifdef USB_DEVICE_HS_SUPPORT
# if UDI_VENDOR_EPS_SIZE_ISO_HS>(MAIN_LOOPBACK_SIZE/2)
#   error UDI_VENDOR_EPS_SIZE_ISO_HS must be <= MAIN_LOOPBACK_SIZE/2 in cond_usb.h
# endif
#endif

void main_vendor_int_in_received(udd_ep_status_t status,
		iram_size_t nb_transfered, udd_ep_id_t ep);
void main_vendor_int_out_received(udd_ep_status_t status,
		iram_size_t nb_transfered, udd_ep_id_t ep);
void main_vendor_bulk_in_received(udd_ep_status_t status,
		iram_size_t nb_transfered, udd_ep_id_t ep);
void main_vendor_bulk_out_received(udd_ep_status_t status,
		iram_size_t nb_transfered, udd_ep_id_t ep);
void main_vendor_iso_in_received(udd_ep_status_t status,
		iram_size_t nb_transfered, udd_ep_id_t ep);
void main_vendor_iso_out_received(udd_ep_status_t status,
		iram_size_t nb_transfered, udd_ep_id_t ep);

/*! \brief Main function. Execution starts here.
 */
int main(void)
{
	irq_initialize_vectors();
	cpu_irq_enable();

	// Initialize the sleep manager
	sleepmgr_init();
#if !SAM0
	sysclk_init();
	board_init();
#else
	system_init();
#endif
	ui_init();

	// Start USB stack to authorize VBus monitoring
	udc_start();

	// The main loop manages only the power mode
	// because the USB management is done by interrupt
	//while (true) {
		//sleepmgr_enter_sleep();
	//}
}

void main_suspend_action(void)
{
	ui_powerdown();
}

void main_resume_action(void)
{
	ui_wakeup();
}

void main_sof_action(void)
{
	if (!main_b_vendor_enable)
		return;
	ui_process(udd_get_frame_number());
}

bool main_vendor_enable(void)
{
	main_b_vendor_enable = true;
	// Start data reception on OUT endpoints
#if UDI_VENDOR_EPS_SIZE_INT_FS
	main_vendor_int_in_received(UDD_EP_TRANSFER_OK, 0, 0);
#endif
#if UDI_VENDOR_EPS_SIZE_BULK_FS
	main_vendor_bulk_in_received(UDD_EP_TRANSFER_OK, 0, 0);
#endif
#if UDI_VENDOR_EPS_SIZE_ISO_FS
	main_buf_iso_sel=0;
	main_vendor_iso_out_received(UDD_EP_TRANSFER_OK, 0, 0);
#endif
	return true;
}

void main_vendor_disable(void)
{
	main_b_vendor_enable = false;
}

bool main_setup_out_received(void)
{
	ui_loop_back_state(true);
	udd_g_ctrlreq.payload = main_buf_loopback;
	udd_g_ctrlreq.payload_size = min(
			udd_g_ctrlreq.req.wLength,
			sizeof(main_buf_loopback));
	return true;
}

bool main_setup_in_received(void)
{
	ui_loop_back_state(false);
	udd_g_ctrlreq.payload = main_buf_loopback;
	udd_g_ctrlreq.payload_size =
			min( udd_g_ctrlreq.req.wLength,
			sizeof(main_buf_loopback) );
	return true;
}

#if UDI_VENDOR_EPS_SIZE_INT_FS
void main_vendor_int_in_received(udd_ep_status_t status,
		iram_size_t nb_transfered, udd_ep_id_t ep)
{
	UNUSED(nb_transfered);
	UNUSED(ep);
	if (UDD_EP_TRANSFER_OK != status) {
		return; // Transfer aborted, then stop loopback
	}
	ui_loop_back_state(false);
	// Wait a full buffer
	udi_vendor_interrupt_out_run(
			main_buf_loopback,
			sizeof(main_buf_loopback),
			main_vendor_int_out_received);
}

void main_vendor_int_out_received(udd_ep_status_t status,
		iram_size_t nb_transfered, udd_ep_id_t ep)
{
	UNUSED(ep);
	if (UDD_EP_TRANSFER_OK != status) {
		return; // Transfer aborted, then stop loopback
	}
	ui_loop_back_state(true);
	// Send on IN endpoint the data received on endpoint OUT
	udi_vendor_interrupt_in_run(
			main_buf_loopback,
			nb_transfered,
			main_vendor_int_in_received);
}
#endif

#if UDI_VENDOR_EPS_SIZE_BULK_FS
void main_vendor_bulk_in_received(udd_ep_status_t status,
		iram_size_t nb_transfered, udd_ep_id_t ep)
{
	UNUSED(nb_transfered);
	UNUSED(ep);
	if (UDD_EP_TRANSFER_OK != status) {
		return; // Transfer aborted, then stop loopback
	}
	//ui_loop_back_state(false);
	// Wait a full buffer
	udi_vendor_bulk_out_run(
			main_buf_loopback,
			sizeof(main_buf_loopback),
			main_vendor_bulk_out_received);
}

void main_vendor_bulk_out_received(udd_ep_status_t status,
		iram_size_t nb_transfered, udd_ep_id_t ep)
{
	UNUSED(ep);
	if (UDD_EP_TRANSFER_OK != status) {
		return; // Transfer aborted, then stop loopback
	}
	//ui_loop_back_state(true);
	// Send on IN endpoint the data received on endpoint OUT
	//gpio_set_pin_high(LED0_GPIO);
	if (nb_transfered == 17500)
		{
		gpio_set_pin_high(LED0_GPIO);
		}
		
	udi_vendor_bulk_in_run(
			main_buf_loopback,
			nb_transfered,
			main_vendor_bulk_in_received);
}
#endif

#if UDI_VENDOR_EPS_SIZE_ISO_FS
void main_vendor_iso_in_received(udd_ep_status_t status,
		iram_size_t nb_transfered, udd_ep_id_t ep)
{
	UNUSED(status);
	UNUSED(nb_transfered);
	UNUSED(ep);
	ui_loop_back_state(false);
}

void main_vendor_iso_out_received(udd_ep_status_t status,
		iram_size_t nb_transfered, udd_ep_id_t ep)
{
	uint8_t *buf_ptr;
	UNUSED(ep);

	if (UDD_EP_TRANSFER_OK != status) {
		return; // Transfer aborted, then stop loopback
	}

	if (nb_transfered) {
		ui_loop_back_state(true);
		// Send on IN endpoint the data received on endpoint OUT
		buf_ptr = &main_buf_loopback[ main_buf_iso_sel
				*(sizeof(main_buf_loopback)/2) ];
		udi_vendor_iso_in_run(
				buf_ptr,
				nb_transfered,
				main_vendor_iso_in_received);
	}

	// Switch of buffer
	main_buf_iso_sel = main_buf_iso_sel? 0:1;

	// Immediately enable a transfer on next USB isochronous OUT packet
	// to avoid to skip a USB packet.
	// NOTE:
	// Here the expected buffer size is equal to endpoint size.
	// Thus, this transfer request will end after reception of
	// one USB packet.
	//
	// When using buffer size larger than endpoint size,
	// the requested transfer is stopped when the buffer is = full*.
	// *on USBC and XMEGA USB driver, the buffer is full
	// when "number of data transfered" > "buffer size" - "endpoint size".
	buf_ptr = &main_buf_loopback[ main_buf_iso_sel
			*(sizeof(main_buf_loopback)/2) ];

	// Send on IN endpoint the data received on endpoint OUT
	udi_vendor_iso_out_run(
			buf_ptr,
			udd_is_high_speed()?
				UDI_VENDOR_EPS_SIZE_ISO_HS:UDI_VENDOR_EPS_SIZE_ISO_FS,
			main_vendor_iso_out_received);
}
#endif

/**
 * \mainpage ASF USB Device Vendor Example
 *
 * \section intro Introduction
 * This example shows how to implement a USB Device implementing Vendor Class
 * on Atmel MCU with USB module.
 *
 * \section startup Startup
 * The example uses a vendor class which implements a loopback on
 * all endpoints types: control, interrupt, bulk and isochronous.
 * After loading firmware, connect the board
 * (EVKxx,Xplain,...) to the USB Host. A Host application developed
 * on libusb library is provided with application note AVR4901.

 * \note
 * When the application is connected for the first time to the PC,
 * the operating system will detect a new peripheral:
 * - This will open a new hardware installation wizard on Windows operating systems.
 * - Choose "No, not this time" to connect to Windows Update for this installation
 * - click "Next"
 * - When requested to search the INF file, browse the avr4901\drivers\ folder
 *   provided package of the AVR4901 application note.
 * - click "Next"
*
 * \copydoc UI
 *
 * \section example About example
 *
 * The example uses the following module groups:
 * - Basic modules:
 *   Startup, board, clock, interrupt, power management
 * - USB Device stack and vendor modules:
 *   <br>services/usb/
 *   <br>services/usb/udc/
 *   <br>services/usb/class/vendor/
 * - Specific implementation:
 *    - main.c,
 *      <br>initializes clock
 *      <br>initializes interrupt
 *      <br>manages UI
 *    - specific implementation for each target "./examples/product_board/":
 *       - conf_foo.h   configuration of each module
 *       - ui.c        implement of user's interface (leds)
 */
