Grix/LASDAC/(commit log)

2016-01-24 arduino branch template AS project
2016-02-04 addeds SPI, blank&center function, started state machine
2016-02-05 finished frame output
2016-02-06 added shutter and led io functions
2016-02-10 hardcoded test frame
2016-02-16 Set frame size for testing
2016-02-19 change some stuff to fit flowchart v2 and ready for lab testing
2016-02-20 fixed testframe, renamed playing flag
    [main.c]
2016-02-24 test frame stuff
2016-03-01 some error handling and bug fixes
    [main.c]
2016-03-03 added not-finished ltspice correction amp circuit
2016-03-06 remove math.h dep. and usb control protocol fix
    [main.c]
2016-03-06 simuleringsfiler med direkte DAC output og ledningssimulering
2016-03-08 adjusted correction amp circuits
2016-03-08 added SMPS schematic and models
2016-03-09 combined circuits
2016-03-25 basic usb frame handling, not tested
2016-03-29 removed smps circuit
2016-04-08 added PCB schematic and board files
    Kicad project with part libraries included.
    TODO: Backwards annotation from PCB to schematic
    [Amplifiers.sch, Channels RGB.sch, Channels XY.sch, DAC.sch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]
2016-04-12 Generated BOM, fixed component names in schematic
    Changed component names on output resistors and status LED to match that
    in PCB
    [Amplifiers.sch, DAC.sch, LASDAC.csv, LASDAC.kicad_pcb, Power.sch, _saved_LASDAC.sch, _saved_Microcontroller.sch]
2016-04-12 Reannotated Components
    Annotated components to standards,
    TODO: Add Silkscreen for signals on bottom
    [Amplifiers.sch, DAC.sch, LASDAC.csv, LASDAC.kicad_pcb, LASDAC.sch, Microcontroller.sch, Power.sch, _saved_LASDAC.sch]
2016-04-13 fixing sam4s board config
    [main.c]
2016-04-15 fixed usb callback function
    [main.c]
2016-04-15 Replaced L1 footprint, changed Resistor values
    [LASDAC.kicad_pcb, Microcontroller.sch, Power.sch]
2016-04-17 Fixed schematic errors, "small" changes to PCB
    Flipped DAC, changed component values, removed 1 capacitor, moved c16
    from vref to power. Developed an urge to kill kicad
    [Amplifiers.sch, DAC.sch, LASDAC.kicad_pcb, Microcontroller.sch, Power.sch]
2016-04-17 Plotted Gerbers
    [LASDAC-B.Cu.gbr, LASDAC-B.Mask.gbr, LASDAC-B.SilkS.gbr, LASDAC-Edge.Cuts.gbr, LASDAC-F.Cu.gbr, LASDAC-F.Mask.gbr, LASDAC-F.SilkS.gbr]
2016-04-17 generated drill file
    [LASDAC-NPTH.drl, LASDAC.drl]
2016-04-17 Resized board
    Resized board to be shorter than 100mm
    [LASDAC-B.Cu.gbr, LASDAC-B.Mask.gbr, LASDAC-B.SilkS.gbr, LASDAC-Edge.Cuts.gbr, LASDAC-F.Cu.gbr, LASDAC-F.Mask.gbr, LASDAC-F.SilkS.gbr, LASDAC-NPTH.drl]
2016-04-17 Added solder paste layers
    [LASDAC-B.Cu.gbr, LASDAC-B.Mask.gbr, LASDAC-B.Paste.gbr, LASDAC-B.SilkS.gbr, LASDAC-Edge.Cuts.gbr, LASDAC-F.Cu.gbr, LASDAC-F.Paste.gbr, LASDAC-F.SilkS.gbr]
2016-04-17 endrer gerber navn
    [LASDAC-NPTH.drl, LASDAC.GBL, LASDAC.GBO, LASDAC.GBS, LASDAC.GTL, LASDAC.GTO, LASDAC.GTS]
2016-04-22 usb og endringer i arduino firmware
2016-04-29 finished control (interrupt) transfer handling in arduino firmware, tweaks
2016-05-03 Started driver folder
2016-05-04 usb driver testing
2016-05-07 8 bug i firmware
    [main.c]
2016-05-22 sleepmgr fixes (but still going to sleep?)
    [main.c]
